ootori-js/pcb-clavier-/(list of files, drawings)

Other design files:
SCH_clavier-mechanique_2026-08-24.json
