ootori-js/pcb-clavier-/carte-linux-f1c200s/carte-linux-f1c200s.kicad_sch

## KiCad design carte-linux-f1c200s/carte-linux-f1c200s.kicad_sch (2026-11-10)

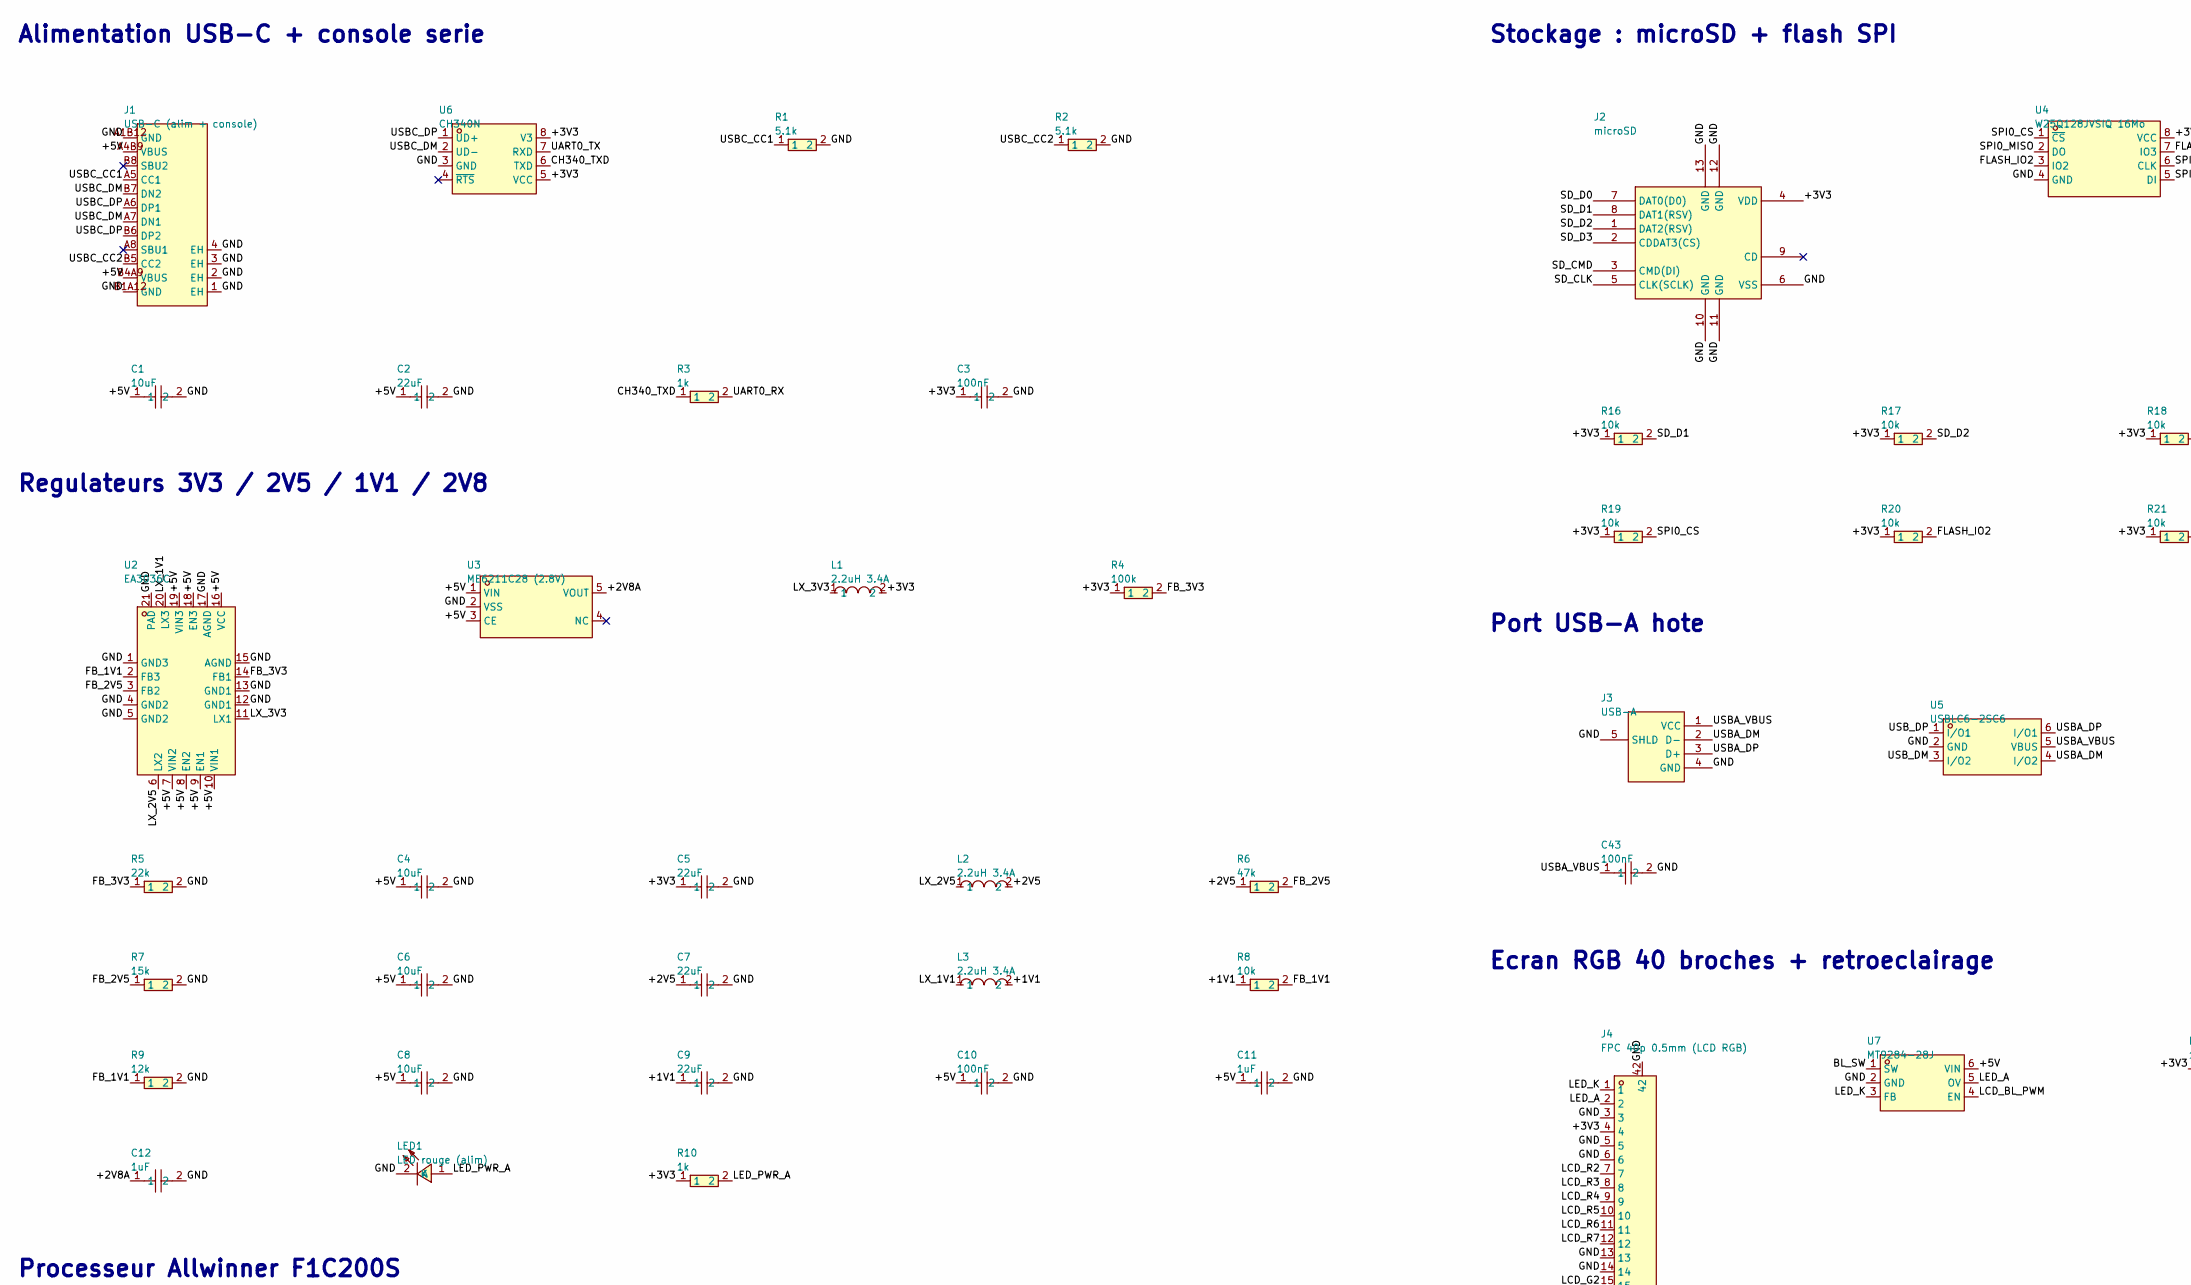
[picture p1: schematic carte-linux-f1c200s.kicad_sch, part in row 1, column 1]

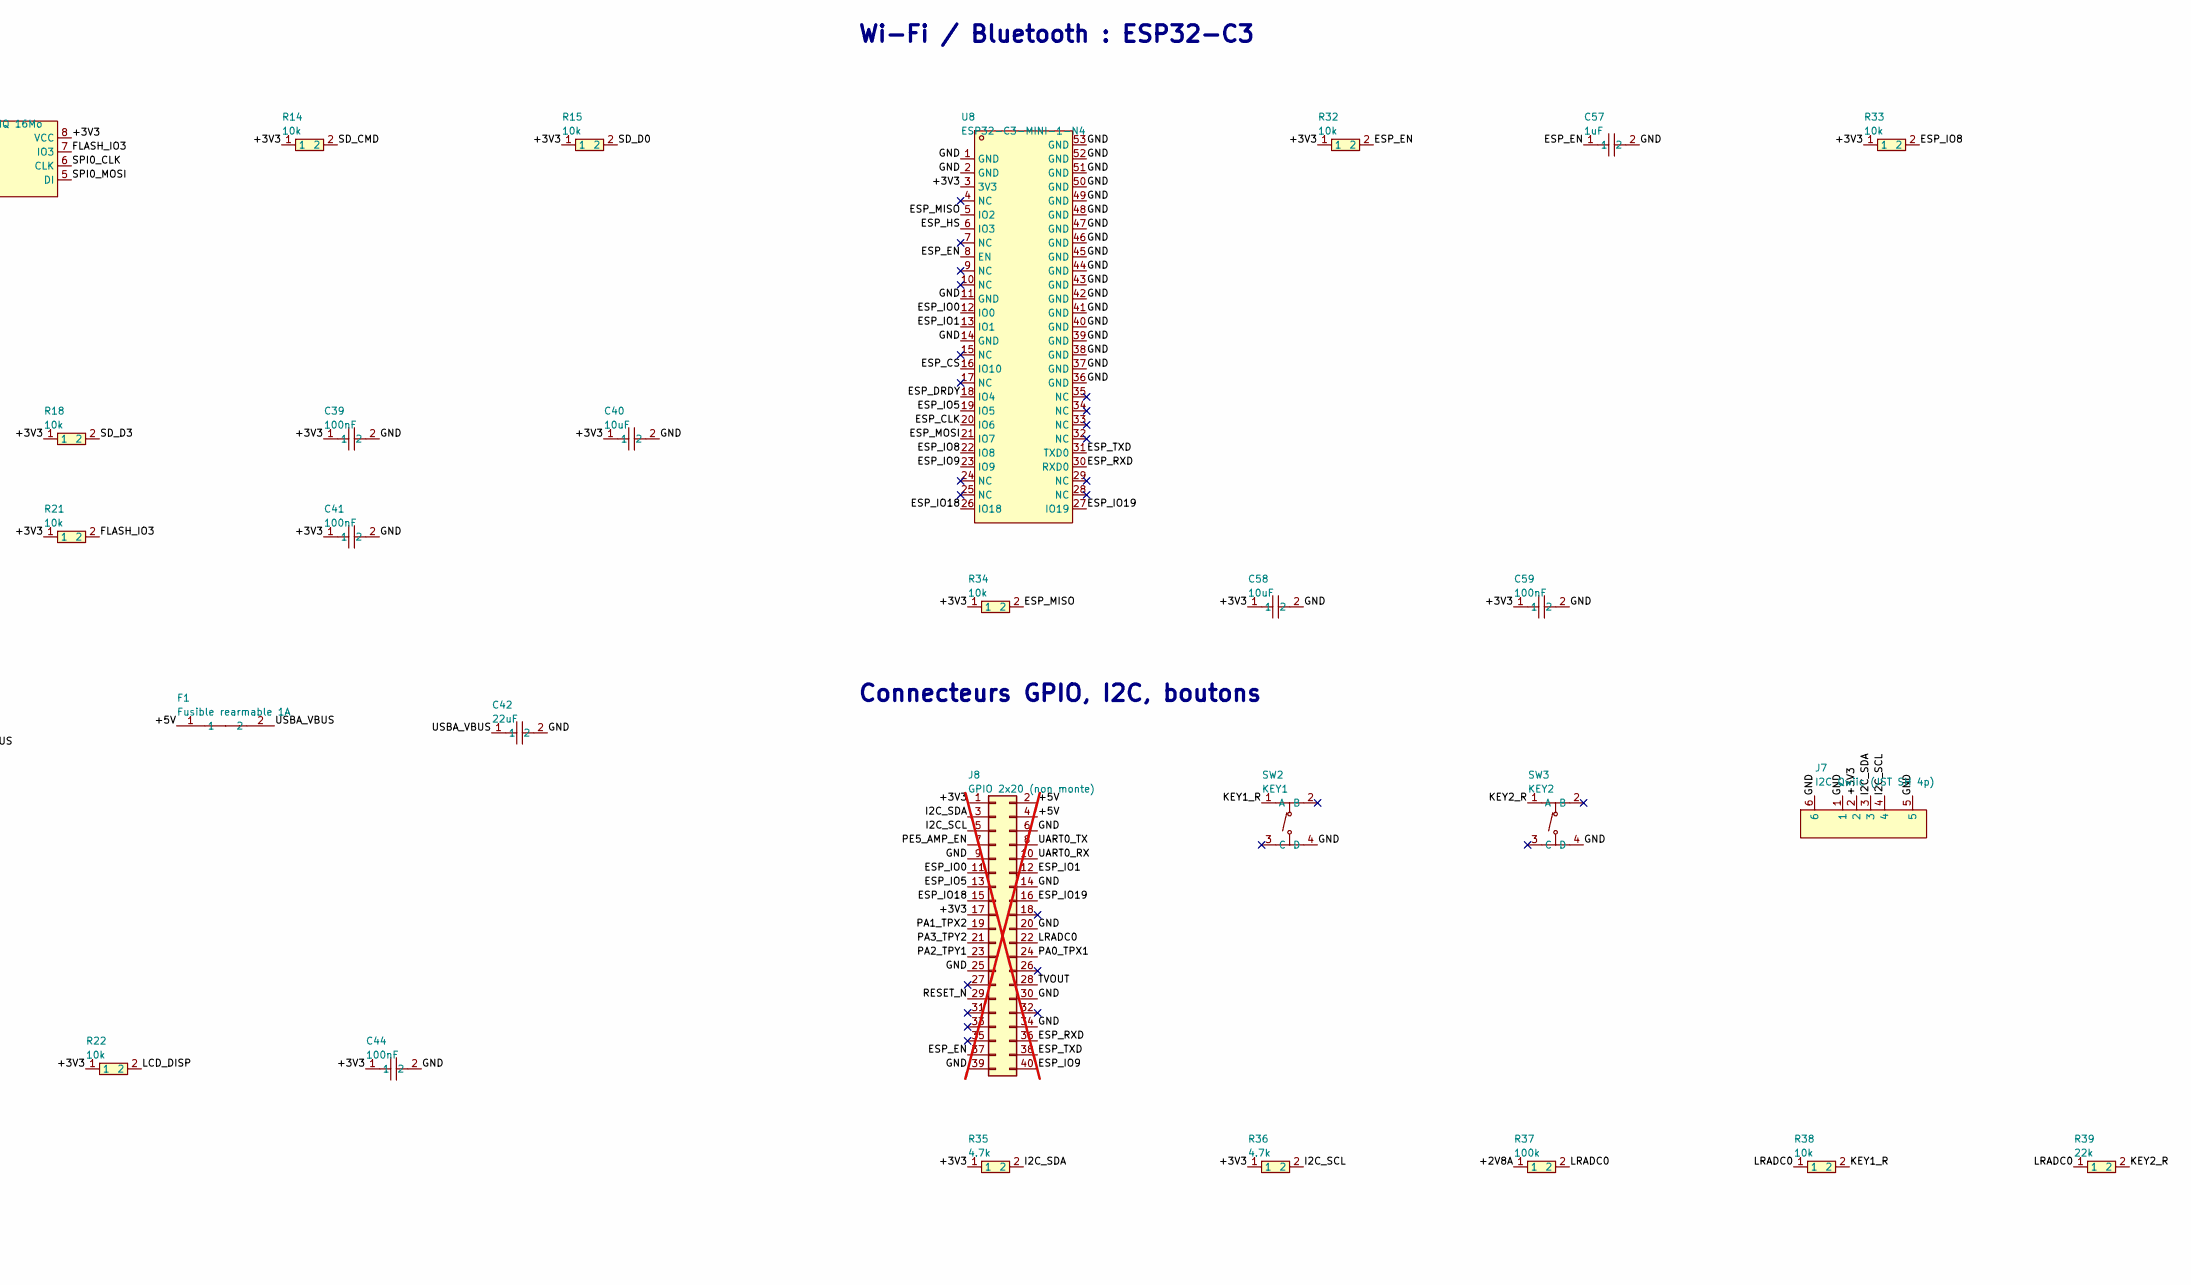
[picture p2: schematic carte-linux-f1c200s.kicad_sch, part in row 1, column 2]

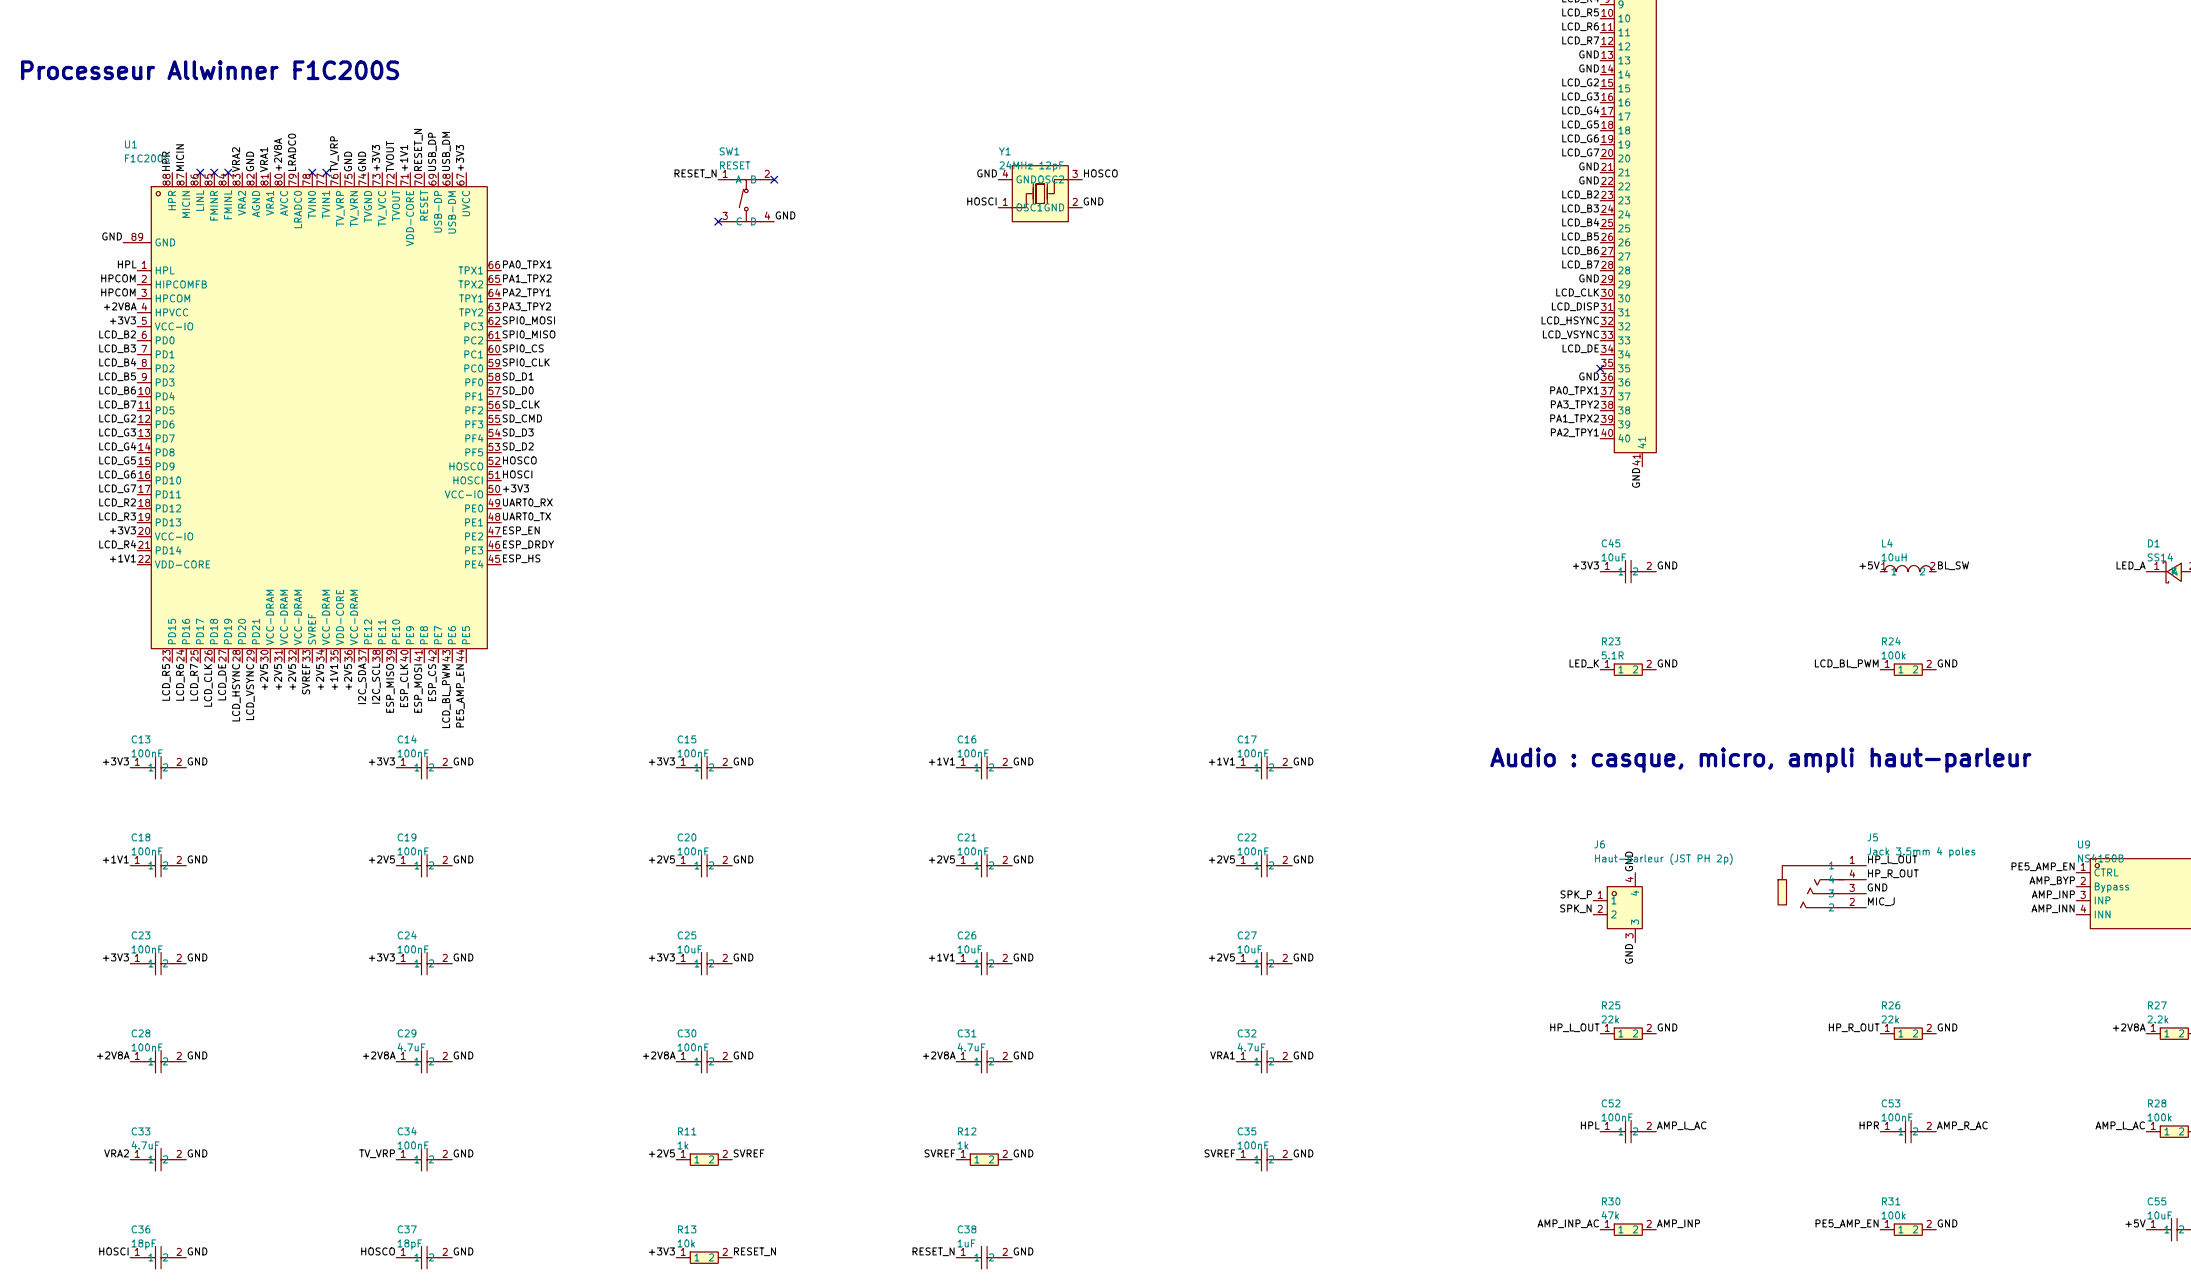
[picture p3: schematic carte-linux-f1c200s.kicad_sch, part in row 2, column 1]

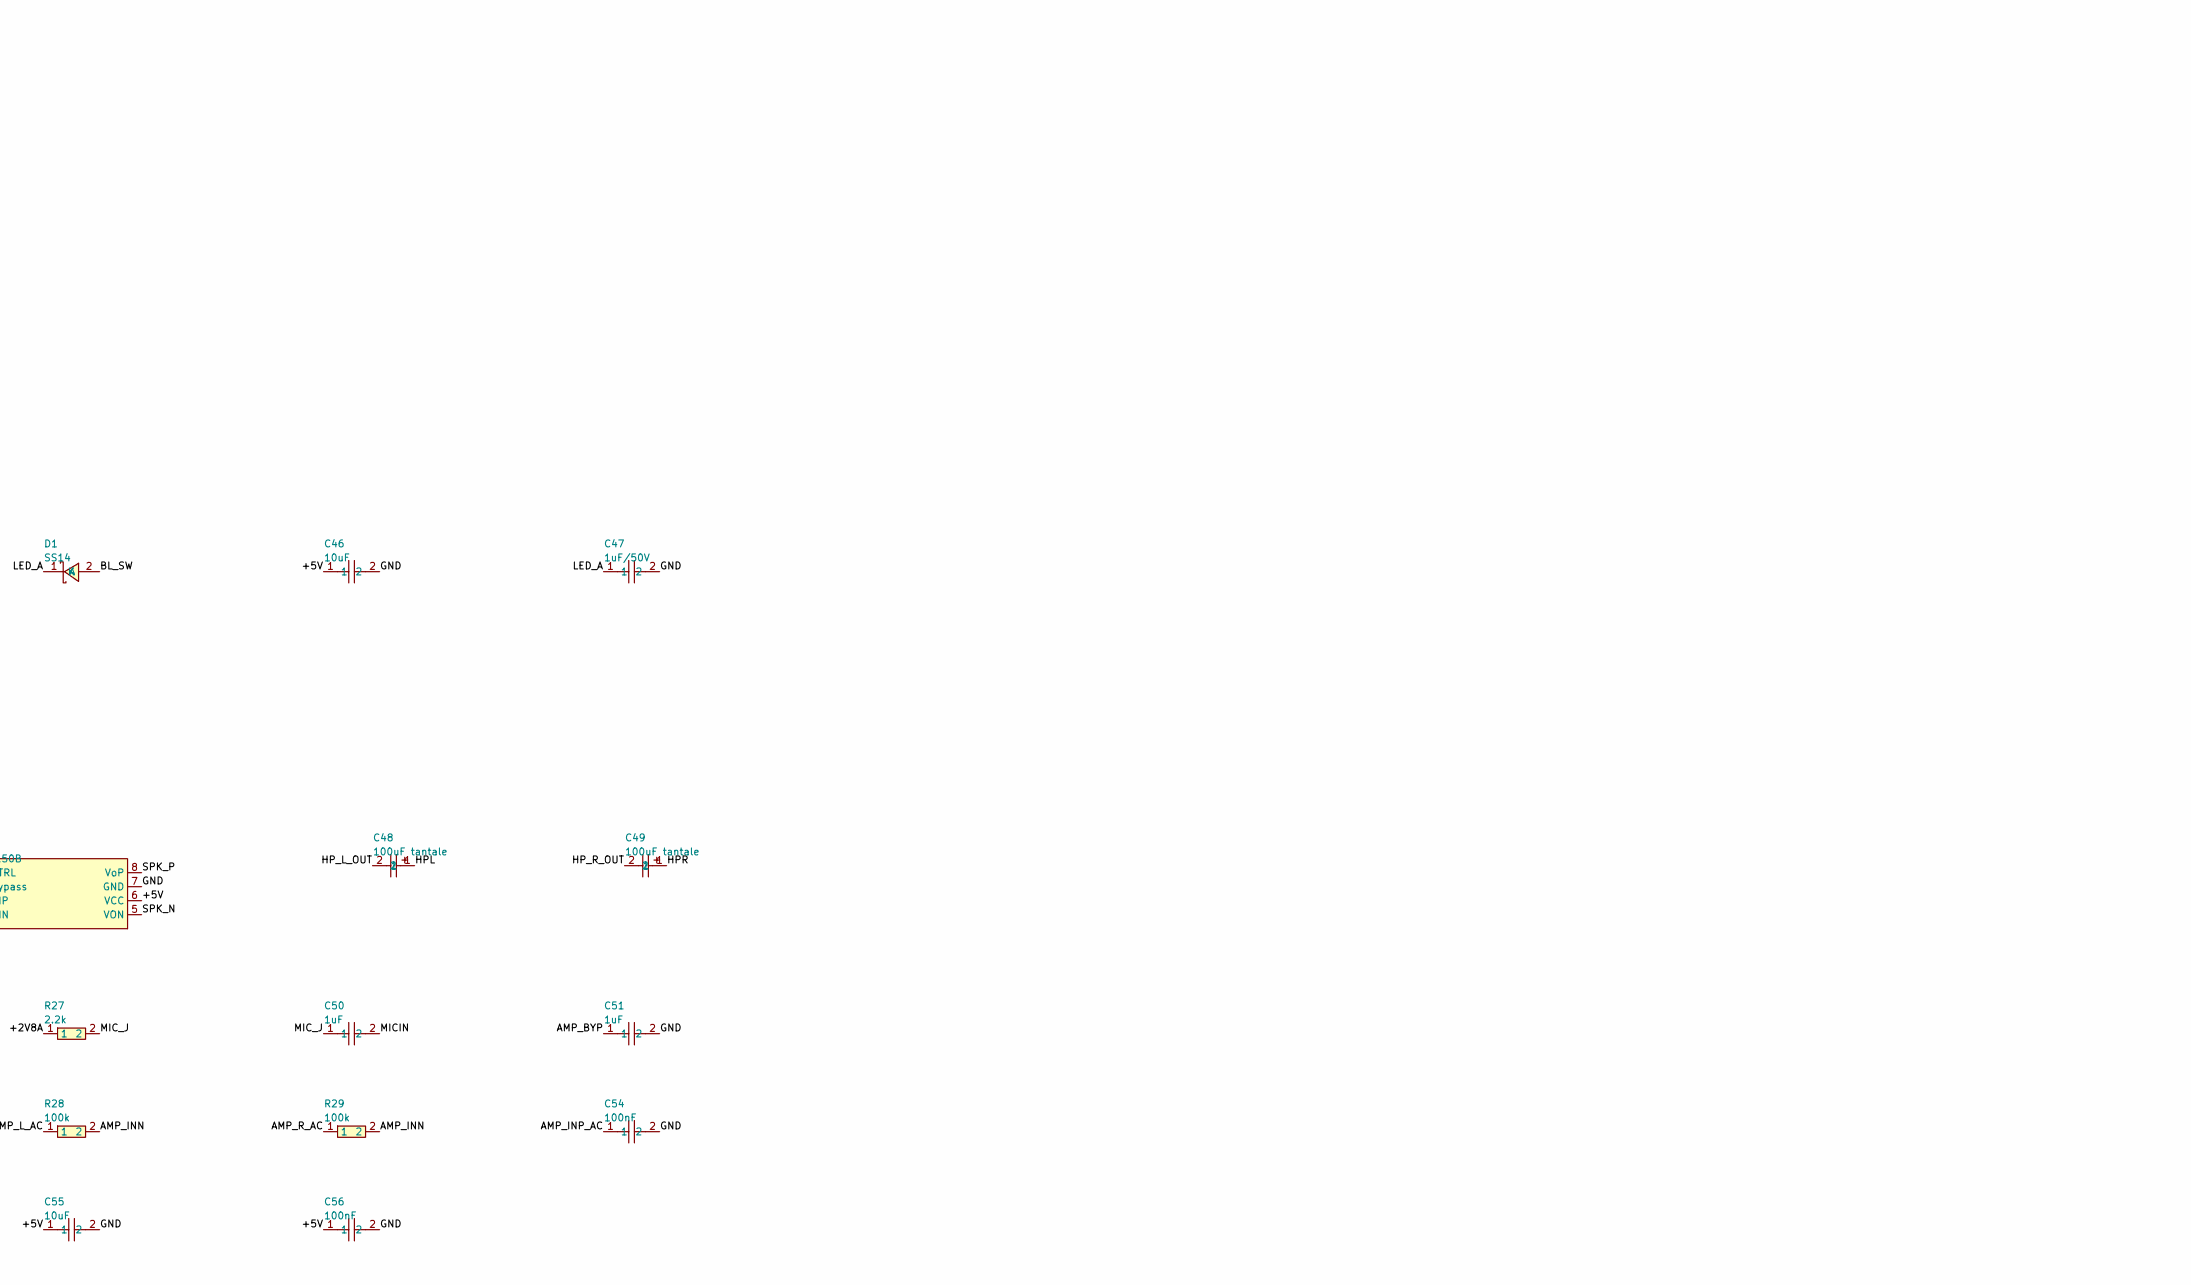
[picture p4: schematic carte-linux-f1c200s.kicad_sch, part in row 2, column 2]

Parts:
C1, C4, C6, C8, C25, C26, C27, C40, C45, C46, C55, C58: 10uF; C0603; LCSC C19702
C2, C5, C7, C9, C42: 22uF; C0805; LCSC C45783
C3, C10, C13, C14, C15, C16, C17, C18, C19, C20, C21, C22, C23, C24, C28, C30, C34, C35, C39, C41, C43, C44, C52, C53, C54, C56, C59: 100nF; C0402; LCSC C1525
C11, C12, C38, C50, C51, C57: 1uF; C0402; LCSC C52923
C29, C31, C32, C33: 4.7uF; C0402; LCSC C23733
C36, C37: 18pF; C0402; LCSC C1549
C47: 1uF/50V; C0603; LCSC C15849
C48, C49: 100uF tantale; CASE-B_3528; LCSC C16133
D1: SS14; SMA_L4.2-W2.6-LS5.0-RD_1; LCSC C2480
F1: Fusible rearmable 1A; F1206; LCSC C70082
J1: USB-C (alim + console); USB-C_SMD-TYPE-C-31-M-12_1; LCSC C165948
J2: microSD; TF-SMD_TF-01A; LCSC C91145
J3: USB-A; USB-A-TH_AF-WJDG; LCSC C456018
J4: FPC 40p 0.5mm (LCD RGB); FPC-SMD_40P-P0.50_05A20L40P; LCSC C5362161
J5: Jack 3.5mm 4 poles; AUDIO-SMD_PJ-320D-1; LCSC C431535
J6: Haut-parleur (JST PH 2p); CONN-SMD_P2.00_S2B-PH-SM4-TB-LF-SN; LCSC C295747
J7: I2C Qwiic (JST SH 4p); CONN-SMD_4P-P1.00_SM04B-SRSS-TB-LF-SN; LCSC C160404
J8: GPIO 2x20 (non monte); PinHeader_2x20_P2.54mm_Vertical; not fitted
L1, L2, L3: 2.2uH 3.4A; IND-SMD_L4.0-W4.0_LQH44PN2R2MP0L; LCSC C135262
L4: 10uH; IND-SMD_L3.0-W3.0_SWPA3010S; LCSC C45403
LED1: LED rouge (alim); LED-SMD_L1.6-W0.8-R-RD; LCSC C2286
R1, R2: 5.1k; R0402; LCSC C25905
R3, R10, R11, R12: 1k; R0402; LCSC C11702
R4, R24, R28, R29, R31, R37: 100k; R0402; LCSC C25741
R5, R25, R26, R39: 22k; R0402; LCSC C25768
R6, R30: 47k; R0402; LCSC C25792
R7: 15k; R0402; LCSC C25756
R8, R13, R14, R15, R16, R17, R18, R19, R20, R21, R22, R32, R33, R34, R38: 10k; R0402; LCSC C25744
R9: 12k; R0402; LCSC C25752
R23: 5.1R; R0603; LCSC C25197
R27: 2.2k; R0402; LCSC C25879
R35, R36: 4.7k; R0402; LCSC C25900
SW1: RESET; SW-SMD_4P-L5.1-W5.1-P3.70-LS6.5-TL_H1.5; LCSC C318884
SW2: KEY1; SW-SMD_4P-L5.1-W5.1-P3.70-LS6.5-TL_H1.5; LCSC C318884
SW3: KEY2; SW-SMD_4P-L5.1-W5.1-P3.70-LS6.5-TL_H1.5; LCSC C318884
U1: F1C200S; QFN-88_L10.0-W10.0-P0.40-BL-EP6.75; LCSC C2879851
U2: EA3036C; WQFN-20_L3.0-W3.0-P0.40-BL-EP; LCSC C570857
U3: ME6211C28 (2.8V); SOT-23-5_L3.0-W1.7-P0.95-LS2.8-BR; LCSC C53099
U4: W25Q128JVSIQ 16Mo; SOIC-8_L5.3-W5.3-P1.27-LS8.0-BL; LCSC C97521
U5: USBLC6-2SC6; SOT-23-6_L2.9-W1.6-P0.95-LS2.8-BL; LCSC C2687116
U6: CH340N; SOP-8_L4.9-W3.9-P1.27-LS6.0-BL; LCSC C2977777
U7: MT9284-28J; SOT-23-6_L2.9-W1.6-P0.95-LS2.8-BR; LCSC C181780
U8: ESP32-C3-MINI-1-N4; WIFIM-SMD_ESP32-C3-MINI-1; LCSC C2838502
U9: NS4150B; MSOP-8_L3.0-W3.0-P0.65-LS5.0-BL; LCSC C189961
Y1: 24MHz 12pF; CRYSTAL-SMD_4P-L3.2-W2.5-BL; LCSC C70590

Connections:
+1V1: C9.1, C16.1, C17.1, C18.1, C26.1, L3.2, R8.1, U1.22 (VDD-CORE), U1.35 (VDD-CORE), U1.71 (VDD-CORE)
+2V5: C7.1, C19.1, C20.1, C21.1, C22.1, C27.1, L2.2, R6.1, R11.1, U1.30 (VCC-DRAM), U1.31 (VCC-DRAM), U1.32 (VCC-DRAM), U1.34 (VCC-DRAM), U1.36 (VCC-DRAM)
+2V8A: C12.1, C28.1, C29.1, C30.1, C31.1, R27.1, R37.1, U1.4 (HPVCC), U1.80 (AVCC), U3.5 (VOUT)
+3V3: C3.1, C5.1, C13.1, C14.1, C15.1, C23.1, C24.1, C25.1, C39.1, C40.1, C41.1, C44.1, C45.1, C58.1, C59.1, J2.4 (VDD), J4.4, J7.2, J8.1, J8.17, L1.2, R4.1, R10.1, R13.1, R14.1, R15.1, R16.1, R17.1, R18.1, R19.1, R20.1, R21.1, R22.1, R32.1, R33.1, R34.1, R35.1, R36.1, U1.5 (VCC-IO), U1.20 (VCC-IO), U1.50 (VCC-IO), U1.67 (UVCC), U1.73 (TV_VCC), U4.8 (VCC), U6.5 (VCC), U6.8 (V3), U8.3 (3V3)
+5V: C1.1, C2.1, C4.1, C6.1, C8.1, C10.1, C11.1, C46.1, C55.1, C56.1, F1.1, J1.A4B9 (VBUS), J1.B4A9 (VBUS), J8.2, J8.4, L4.1, U2.7 (VIN2), U2.8 (EN2), U2.9 (EN1), U2.10 (VIN1), U2.16 (VCC), U2.18 (EN3), U2.19 (VIN3), U3.1 (VIN), U3.3 (CE), U7.6 (VIN), U9.6 (VCC)
AMP_BYP: C51.1, U9.2 (Bypass)
AMP_INN: R28.2, R29.2, U9.4 (INN)
AMP_INP: R30.2, U9.3 (INP)
AMP_INP_AC: C54.1, R30.1
AMP_L_AC: C52.2, R28.1
AMP_R_AC: C53.2, R29.1
BL_SW: D1.2 (A), L4.2, U7.1 (SW)
CH340_TXD: R3.1, U6.6 (TXD)
ESP_CLK: U1.40 (PE9), U8.20 (IO6)
ESP_CS: U1.42 (PE7), U8.16 (IO10)
ESP_DRDY: U1.46 (PE3), U8.18 (IO4)
ESP_EN: C57.1, J8.37, R32.2, U1.47 (PE2), U8.8 (EN)
ESP_HS: U1.45 (PE4), U8.6 (IO3)
ESP_IO0: J8.11, U8.12 (IO0)
ESP_IO1: J8.12, U8.13 (IO1)
ESP_IO5: J8.13, U8.19 (IO5)
ESP_IO8: R33.2, U8.22 (IO8)
ESP_IO9: J8.40, U8.23 (IO9)
ESP_IO18: J8.15, U8.26 (IO18)
ESP_IO19: J8.16, U8.27 (IO19)
ESP_MISO: R34.2, U1.39 (PE10), U8.5 (IO2)
ESP_MOSI: U1.41 (PE8), U8.21 (IO7)
ESP_RXD: J8.36, U8.30 (RXD0)
ESP_TXD: J8.38, U8.31 (TXD0)
FB_1V1: R8.2, R9.1, U2.2 (FB3)
FB_2V5: R6.2, R7.1, U2.3 (FB2)
FB_3V3: R4.2, R5.1, U2.14 (FB1)
FLASH_IO2: R20.2, U4.3 (IO2)
FLASH_IO3: R21.2, U4.7 (IO3)
GND: C1.2, C2.2, C3.2, C4.2, C5.2, C6.2, C7.2, C8.2, C9.2, C10.2, C11.2, C12.2, C13.2, C14.2, C15.2, C16.2, C17.2, C18.2, C19.2, C20.2, C21.2, C22.2, C23.2, C24.2, C25.2, C26.2, C27.2, C28.2, C29.2, C30.2, C31.2, C32.2, C33.2, C34.2, C35.2, C36.2, C37.2, C38.2, C39.2, C40.2, C41.2, C42.2, C43.2, C44.2, C45.2, C46.2, C47.2, C51.2, C54.2, C55.2, C56.2, C57.2, C58.2, C59.2, J1.1 (EH), J1.2 (EH), J1.3 (EH), J1.4 (EH), J1.A1B12 (GND), J1.B1A12 (GND), J2.6 (VSS), J2.10 (GND), J2.11 (GND), J2.12 (GND), J2.13 (GND), J3.4 (GND), J3.5 (SHLD), J4.3, J4.5, J4.6, J4.13, J4.14, J4.21, J4.22, J4.29, J4.36, J4.41, J4.42, J5.3, J6.3, J6.4, J7.1, J7.5, J7.6, J8.6, J8.9, J8.14, J8.20, J8.25, J8.30, J8.34, J8.39, LED1.2 (K), R1.2, R2.2, R5.2, R7.2, R9.2, R12.2, R23.2, R24.2, R25.2, R26.2, R31.2, SW1.4 (D), SW2.4 (D), SW3.4 (D), U1.74 (TVGND), U1.75 (TV_VRN), U1.82 (AGND), U1.89 (GND), U2.1 (GND3), U2.4 (GND2), U2.5 (GND2), U2.12 (GND1), U2.13 (GND1), U2.15 (AGND), U2.17 (AGND), U2.21 (PAD), U3.2 (VSS), U4.4 (GND), U5.2 (GND), U6.3 (GND), U7.2 (GND), U8.1 (GND), U8.2 (GND), U8.11 (GND), U8.14 (GND), U8.36 (GND), U8.37 (GND), U8.38 (GND), U8.39 (GND), U8.40 (GND), U8.41 (GND), U8.42 (GND), U8.43 (GND), U8.44 (GND), U8.45 (GND), U8.46 (GND), U8.47 (GND), U8.48 (GND), U8.49 (GND), U8.50 (GND), U8.51 (GND), U8.52 (GND), U8.53 (GND), U9.7 (GND), Y1.2 (GND), Y1.4 (GND)
HOSCI: C36.1, U1.51 (HOSCI), Y1.1 (OSC1)
HOSCO: C37.1, U1.52 (HOSCO), Y1.3 (OSC2)
HPCOM: U1.2 (HIPCOMFB), U1.3 (HPCOM)
HPL: C48.1, C52.1, U1.1 (HPL)
HPR: C49.1, C53.1, U1.88 (HPR)
HP_L_OUT: C48.2, J5.1, R25.1
HP_R_OUT: C49.2, J5.4, R26.1
I2C_SCL: J7.4, J8.5, R36.2, U1.38 (PE11)
I2C_SDA: J7.3, J8.3, R35.2, U1.37 (PE12)
KEY1_R: R38.2, SW2.1 (A)
KEY2_R: R39.2, SW3.1 (A)
LCD_B2: J4.23, U1.6 (PD0)
LCD_B3: J4.24, U1.7 (PD1)
LCD_B4: J4.25, U1.8 (PD2)
LCD_B5: J4.26, U1.9 (PD3)
LCD_B6: J4.27, U1.10 (PD4)
LCD_B7: J4.28, U1.11 (PD5)
LCD_BL_PWM: R24.1, U1.43 (PE6), U7.4 (EN)
LCD_CLK: J4.30, U1.26 (PD18)
LCD_DE: J4.34, U1.27 (PD19)
LCD_DISP: J4.31, R22.2
LCD_G2: J4.15, U1.12 (PD6)
LCD_G3: J4.16, U1.13 (PD7)
LCD_G4: J4.17, U1.14 (PD8)
LCD_G5: J4.18, U1.15 (PD9)
LCD_G6: J4.19, U1.16 (PD10)
LCD_G7: J4.20, U1.17 (PD11)
LCD_HSYNC: J4.32, U1.28 (PD20)
LCD_R2: J4.7, U1.18 (PD12)
LCD_R3: J4.8, U1.19 (PD13)
LCD_R4: J4.9, U1.21 (PD14)
LCD_R5: J4.10, U1.23 (PD15)
LCD_R6: J4.11, U1.24 (PD16)
LCD_R7: J4.12, U1.25 (PD17)
LCD_VSYNC: J4.33, U1.29 (PD21)
LED_A: C47.1, D1.1 (K), J4.2, U7.5 (OV)
LED_K: J4.1, R23.1, U7.3 (FB)
LED_PWR_A: LED1.1 (A), R10.2
LRADC0: J8.22, R37.2, R38.1, R39.1, U1.79 (LRADC0)
LX_1V1: L3.1, U2.20 (LX3)
LX_2V5: L2.1, U2.6 (LX2)
LX_3V3: L1.1, U2.11 (LX1)
MICIN: C50.2, U1.87 (MICIN)
MIC_J: C50.1, J5.2, R27.2
PA0_TPX1: J4.37, J8.24, U1.66 (TPX1)
PA1_TPX2: J4.39, J8.19, U1.65 (TPX2)
PA2_TPY1: J4.40, J8.23, U1.64 (TPY1)
PA3_TPY2: J4.38, J8.21, U1.63 (TPY2)
PE5_AMP_EN: J8.7, R31.1, U1.44 (PE5), U9.1 (CTRL)
RESET_N: C38.1, J8.29, R13.2, SW1.1 (A), U1.70 (RESET)
SD_CLK: J2.5 (CLK(SCLK)), U1.56 (PF2)
SD_CMD: J2.3 (CMD(DI)), R14.2, U1.55 (PF3)
SD_D0: J2.7 (DAT0(D0)), R15.2, U1.57 (PF1)
SD_D1: J2.8 (DAT1(RSV)), R16.2, U1.58 (PF0)
SD_D2: J2.1 (DAT2(RSV)), R17.2, U1.53 (PF5)
SD_D3: J2.2 (CDDAT3(CS)), R18.2, U1.54 (PF4)
SPI0_CLK: U1.59 (PC0), U4.6 (CLK)
SPI0_CS: R19.2, U1.60 (PC1), U4.1 (~CS)
SPI0_MISO: U1.61 (PC2), U4.2 (DO)
SPI0_MOSI: U1.62 (PC3), U4.5 (DI)
SPK_N: J6.2, U9.5 (VON)
SPK_P: J6.1, U9.8 (VoP)
SVREF: C35.1, R11.2, R12.1, U1.33 (SVREF)
TVOUT: J8.28, U1.72 (TVOUT)
TV_VRP: C34.1, U1.76 (TV_VRP)
UART0_RX: J8.10, R3.2, U1.49 (PE0)
UART0_TX: J8.8, U1.48 (PE1), U6.7 (RXD)
USBA_DM: J3.2 (D-), U5.4 (I/O2)
USBA_DP: J3.3 (D+), U5.6 (I/O1)
USBA_VBUS: C42.1, C43.1, F1.2, J3.1 (VCC), U5.5 (VBUS)
USBC_CC1: J1.A5 (CC1), R1.1
USBC_CC2: J1.B5 (CC2), R2.1
USBC_DM: J1.A7 (DN1), J1.B7 (DN2), U6.2 (UD-)
USBC_DP: J1.A6 (DP1), J1.B6 (DP2), U6.1 (UD+)
USB_DM: U1.68 (USB-DM), U5.3 (I/O2)
USB_DP: U1.69 (USB-DP), U5.1 (I/O1)
VRA1: C32.1, U1.81 (VRA1)
VRA2: C33.1, U1.83 (VRA2)

Notes on the sheet:
Alimentation USB-C + console serie
Regulateurs 3V3 / 2V5 / 1V1 / 2V8
Processeur Allwinner F1C200S
Stockage : microSD + flash SPI
Port USB-A hote
Ecran RGB 40 broches + retroeclairage
Audio : casque, micro, ampli haut-parleur
Wi-Fi / Bluetooth : ESP32-C3
Connecteurs GPIO, I2C, boutons
