ootori-js/pcb-clavier-/carte-linux-f1c200s/gen/placement.py

"""Component placement: ref -> (x mm, y mm, rotation deg).  Board is 85 x 56 mm,
origin at the top-left corner, y pointing down (KiCad convention)."""

BOARD_W, BOARD_H = 85.0, 56.0
HOLES = [(3.5, 3.5), (61.5, 3.5), (3.5, 52.5), (61.5, 52.5)]     # Raspberry Pi pattern
ANTENNA_KEEPOUT = (68.6, 0.0, 83.4, 6.6)                           # x1, y1, x2, y2

PLACE = {
    # ---- connectors on the edges
    'J8': (8.37, 4.77, 90),       # 2x20 header, Raspberry Pi position
    'J3': (10.8, 16.0, 270),      # USB-A, left edge
    'J5': (7.0, 31.0, 0),         # audio jack, left edge
    'J7': (3.0, 41.5, 270),       # Qwiic, left edge
    'J1': (15.0, 51.8, 0),        # USB-C, bottom edge
    'SW1': (25.3, 52.6, 0),       # reset
    'J4': (42.0, 51.0, 0),        # LCD FPC, bottom edge
    'SW2': (69.5, 52.6, 0),
    'SW3': (78.0, 52.6, 0),
    'J6': (80.3, 43.0, 90),       # speaker, right edge
    'J2': (75.6, 28.8, 90),       # microSD, right edge
    'U8': (76.4, 12.2, 0),        # ESP32-C3, antenna at the top edge

    # ---- processor and its decoupling
    'U1': (40.0, 28.0, 0),
    'C18': (32.3, 25.3, 180), 'C24': (32.3, 26.6, 180), 'C34': (32.3, 27.9, 180),
    'C28': (32.3, 29.2, 180), 'C32': (32.3, 30.5, 180), 'C33': (32.3, 31.8, 180),
    'C29': (29.9, 29.2, 180), 'C31': (29.9, 30.6, 180), 'R37': (29.9, 27.8, 180),
    'C23': (33.0, 22.4, 180), 'C25': (33.2, 20.6, 180),
    'C30': (33.9, 34.3, 270), 'C13': (32.5, 34.3, 270),
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

    # ---- I2C, keys
    'R35': (7.2, 38.6, 90), 'R36': (8.6, 38.6, 90),
    'R38': (72.4, 49.2, 0), 'R39': (74.6, 49.2, 0),
}
# power LED next to the USB-C connector instead of under the header
PLACE['LED1'] = (5.4, 47.6, 0)
PLACE['R10'] = (5.4, 49.2, 0)
