ootori-js/pcb-clavier-/(commit log)

2026-11-10 Add F1C200S Linux board: circuit description and generated schematic
    Claude-Session: https://claude.ai/code/session_018W44uMhcq3q5Sf2ep7ax3M
    [carte-linux-f1c200s.kicad_sch]
2026-11-10 Add board placement table and PCB build script (not yet run)
    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
